javicone/LoRaLAN_TFG/TFG_JavierConejero_Latex/portada/portadaCUMDatos.tex

\pagestyle{empty}

\begin{center}
	\newcommand{\HRule}{\rule{\linewidth}{0.7mm}}
	\begin{minipage}{0.48\textwidth} 
		\begin{flushleft}
			\\[2.5cm]
		\end{flushleft}
	\end{minipage}
	\begin{minipage}{0.48\textwidth} 
		\begin{flushright}
			\\[2.5cm]
		\end{flushright}
	\end{minipage}	
	
	\vspace*{2cm}
	\textsc{\large Universidad de Extremadura}\\[0.5cm]
	\textsc{\large Centro Universitario de Mérida}\\[1.3cm]
	\textsc{\LARGE Grado en Ingeniería Telemática en Telecomunicación}\\[1.3cm]
	\textsc{\huge Trabajo Fin de Grado}\\[2cm]
	%{ \large Diseño de metaheurísticas especializadas para la optimización de cadenas de servicios en redes 5G}\\
	\textsc{\LARGE Diseño e implementación de un protocolo de red de área local sobre tecnología LoRa para redes privadas orientadas a IoT}\\[2.5 cm]
\end{center}

\begin{flushleft}
	\begin{tabular}{ll}
		% Nombre del alumno.
		\large{\textbf{Autor:}}
		\large{Javier Conejero Rodríguez} \\
		\large{\textbf{Fdo:}} & \\
		\\
		\\
		\\
		% Nombre del director/tutor del proyecto.
		\large{\textbf{Tutor:}}
        \large{Pedro José Pardo Fernández} \\
        \large{\textbf{  Fdo:}}\\
        \\
        \\
        \\
        \large{\textbf{Tutor:}}
        \large{Francisco Díaz Barrancas} \\
        \large{\textbf{  Fdo:}}\\
	\end{tabular}
\end{flushleft}
