javicone/LoRaLAN_TFG/TFG_JavierConejero_Latex/principal.tex

\documentclass[a4paper,12pt,openright,twoside]{book}  

%Paquetes
\usepackage[utf8]{inputenc}
\usepackage[spanish]{babel}
\usepackage{graphicx} 
\usepackage{array}
\usepackage{wrapfig}   
\usepackage[scriptsize]{caption} 
\usepackage{amsmath} 
\usepackage{amsthm}  
\usepackage{float}   
\usepackage{lastpage}
\usepackage{pdfpages}
\usepackage{url}
% Package rotating -> Para poder girar las tablas y dibujarlas a lo largo
% del folio en vez de a lo ancho.
\usepackage{rotating}
% Packages multicol y multirow, para manejar tablas de filas y columnas múltiples.
\usepackage{multicol}
\usepackage{multirow}
\usepackage{colortbl}
%Para codigo maquina
\usepackage{listings}
%Para hypervínculos en el indice
\usepackage[hidelinks]{hyperref}
\usepackage{pdfpages}
\usepackage{lscape}
\usepackage{eurosym}
\usepackage{listings}
\usepackage{xcolor}

\usepackage{tabularx}
\usepackage{booktabs}
\usepackage{longtable}

\usepackage{array}

\lstdefinestyle{sharpc}{language=[Sharp]C}

\usepackage{appendix}

\usepackage{epstopdf} 
\usepackage{subcaption}
%Renombramientos

\usepackage{enumitem}
\usepackage{tikz}
\newcommand*\circled[1]{\tikz[baseline=(c.base)]{
    \node[shape=circle,fill=black,text=white,inner sep=1.2pt,
          font=\footnotesize\bfseries] (c) {#1};}}

\renewcommand{\contentsname}{Índice de contenido}
\renewcommand{\chaptername}{Capítulo}            
\renewcommand{\bibname}{References} 
\renewcommand{\listfigurename}{Índice de figuras}
\renewcommand{\listtablename}{Índice de tablas}
\renewcommand{\figurename}{Figura}
\renewcommand{\tablename}{Tabla}
\addto\captionsspanish{\renewcommand{\appendixname}{Anexo}}
%\renewcommand{\appendixname}{Anexo}
\renewcommand{\appendixtocname}{Anexos}
\renewcommand{\appendixpagename}{Anexos}
\renewcommand{\lstlistingname}{Listado}

\newcolumntype{C}[1]{>{\centering\arraybackslash}m{#1}}

\providecommand{\keywords}[1]{\textbf{\textit{Keywords---}} #1}

%\setcounter{secnumdepth}{4}
%\setcounter{tocdepth}{4}

%Configuración páginas
\include{config/paginas}

\begin{document}

\include{portada/portadaCUM}
\cleardoublepage
\include{portada/portadaCUMDatos}
\cleardoublepage

\pagestyle{plain}
\pagenumbering{Roman} % para comenzar la numeración de paginas en números romanos

\include{paginasiniciales/agradecimientos}
\cleardoublepage

\include{paginasiniciales/resumen}
\cleardoublepage

\include{paginasiniciales/abstract}
\cleardoublepage

\pagestyle{plain}
\tableofcontents

\addcontentsline{toc}{chapter}{Índice de figuras}
\listoffigures

\cleardoublepage
%\addcontentsline{toc}{chapter}{Índice de tablas}
%\listoftables
%\cleardoublepage

%\pagestyle{fancy} 
\pagenumbering{arabic}

% CAPÍTULOS -----------------------------------
\include{capitulos/capitulo1}
\include{capitulos/capitulo2}
\include{capitulos/capitulo3}
\include{capitulos/capitulo4}
\include{capitulos/capitulo5}
\include{capitulos/capitulo6}
\include{capitulos/capitulo7}
\include{capitulos/capitulo8}
% etc...

%----------------------------------------------------
% INCLUIMOS LOS ANEXOS (SI ES NECESARIO)
\appendix
\clearpage
\addappheadtotoc
\appendixpage
\include{anexos/an1}
\include{anexos/an2}
\include{anexos/an3}
\include{anexos/an4}

\addcontentsline{toc}{chapter}{Bibliografía}
%\nocite{*}	% Se usa para indicar en la bibliografía las referencias no citadas.
\pagestyle{plain}
\bibliography{bibliografia/referencias}{}
\bibliographystyle{ieeetr}
%\bibliographystyle{plain}
\end{document}
