javicone/LoRaLAN_TFG/TFG_JavierConejero_Latex/paginasiniciales/ack.tex

\chapter*{Agradecimientos} 
\addcontentsline{toc}{chapter}{Agradecimientos} % si queremos que aparezcan en el índice
  Si tienes algo que agradecer
