javicone/LoRaLAN_TFG/TFG_JavierConejero_Latex/paginasiniciales/agradecimientos.tex

\chapter*{Agradecimientos}

¡Al fin cierro mi etapa como estudiante universitario!

Quería agredecer a mi tutor, Pedro, todo el apoyo brindado durante la realización de este trabajo. Sin su ambición este proyecto no habría sido posible y, de primeras, jamás me hubiera lanzado a trabajar a tan bajo nivel diseñando un protocolo dede cero.

Este trabajo ha supuesto un reto para mi, no por la complejidad del contenido en sí mismo, sino por la dificultad que conlleva trabajar con materias tan diferenciadas. 

Gracias también a ti, Sofía. Desde que estás en mi vida solo me han pasado cosas buenas y las que no han sido buenas, han sido menos malas. Eres capaz de sacar lo mejor de mí y eso no tiene precio. Siempre estaré ahí, para apoyarte y ayudarte, al igual que tú haces conmigo.
