javicone/LoRaLAN_TFG/TFG_JavierConejero_Latex/imagenes/IMG_20261105_010422259.jpg

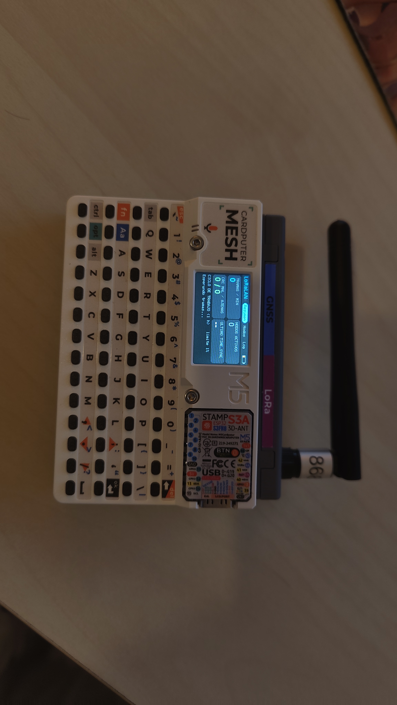
TFG_JavierConejero_Latex/imagenes/IMG_20261105_010422259.jpg
