javicone/LoRaLAN_TFG/TFG_JavierConejero_Latex/imagenes/IMG_20261105_010449758.jpg

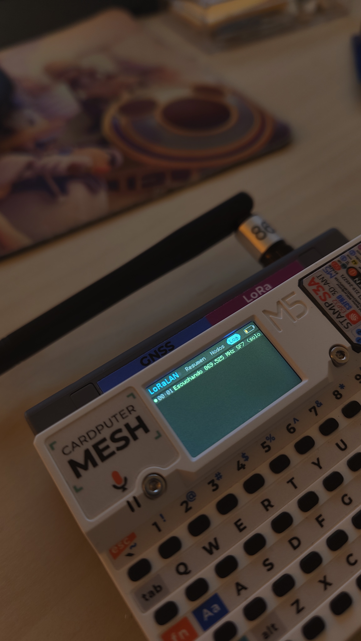
TFG_JavierConejero_Latex/imagenes/IMG_20261105_010449758.jpg
