javicone/LoRaLAN_TFG/TFG_JavierConejero_Latex/imagenes/lorawan.webp

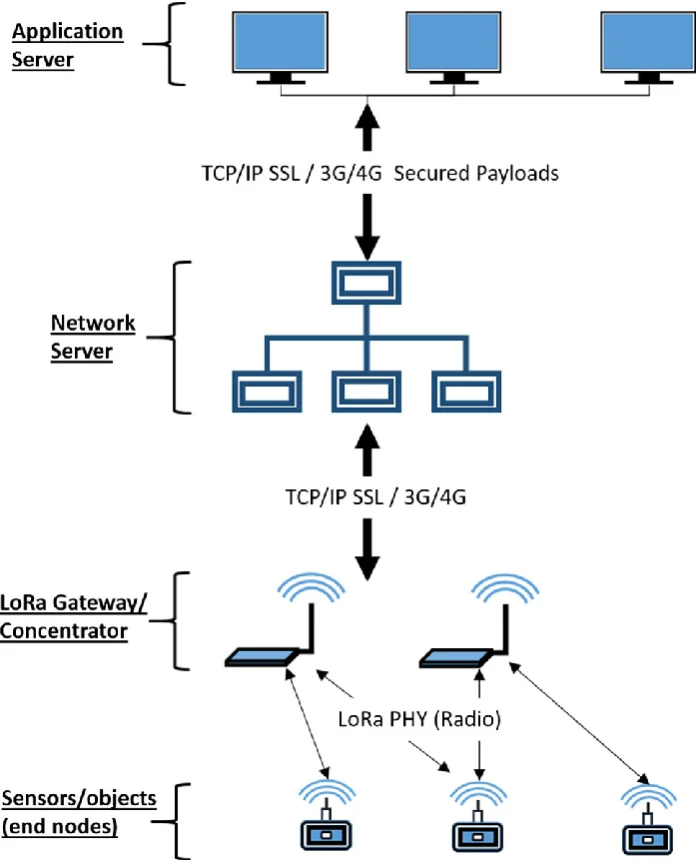
TFG_JavierConejero_Latex/imagenes/lorawan.webp
