javicone/LoRaLAN_TFG/TFG_JavierConejero_Latex/imagenes/TRAMA LORALAN.png

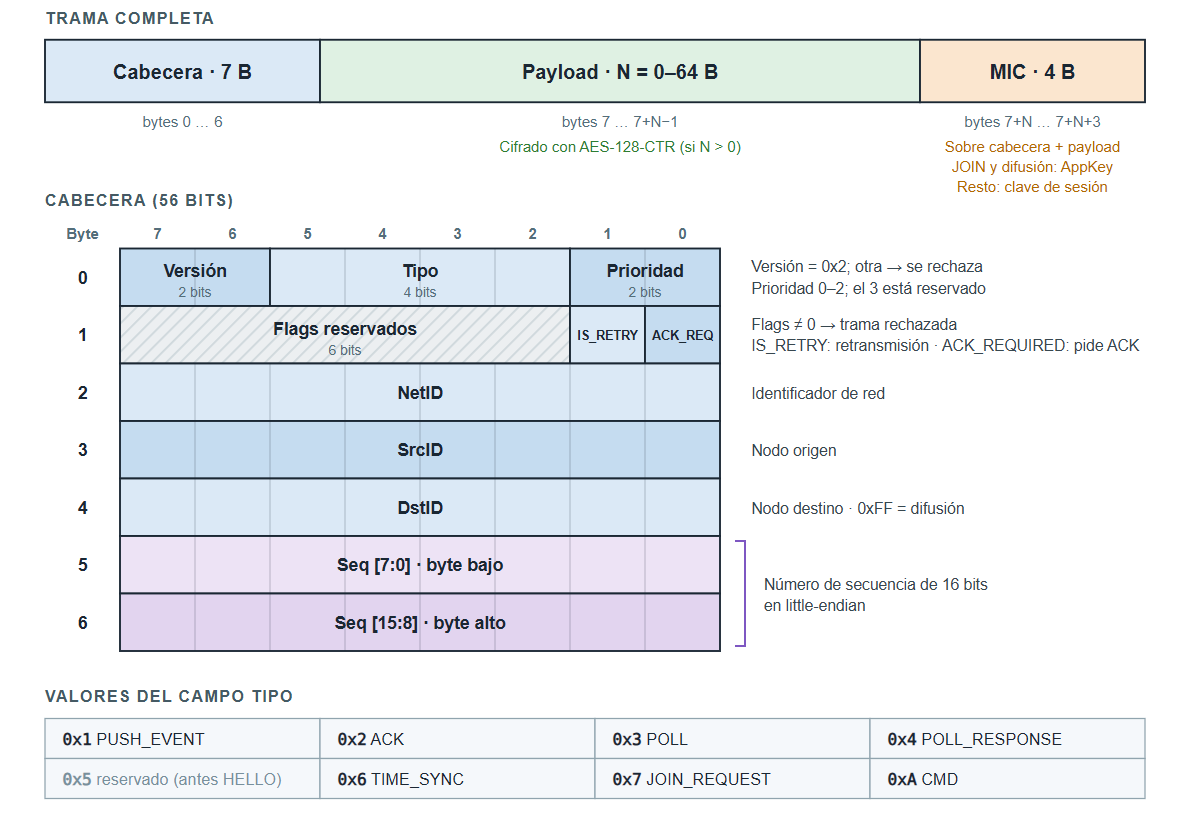
TFG_JavierConejero_Latex/imagenes/TRAMA LORALAN.png
