javicone/LoRaLAN_TFG/LORALAN_LIB/sim_LoRaLAN/results/casos.csv

id | familia | titulo | fecha_esperado | precondiciones | estimulo | requisito | propiedad | veredicto | conocido | observado | semilla
D1 | ACK | La aplicacion responde rapido | 2026-11-01 | Gateway con ACK diferido | Respuesta a los 100 ms | PRO-3 | El codigo llega al nodo dentro del ACK, sin retransmisiones | Superada |  |  | 42
D2 | ACK | La aplicacion responde tarde | 2026-11-01 | Gateway con ACK diferido | Respuesta a los 2000 ms | PRO-3 | El nodo repite durante la espera, pero la aplicacion no recibe duplicado | Superada |  |  | 42
D2 | ACK | La aplicacion responde tarde | 2026-11-01 | Gateway con ACK diferido | Respuesta a los 2000 ms | PRO-3 | La respuesta llega al nodo | Superada |  |  | 42
D3 | ACK | ACK con la respuesta perdido | 2026-11-01 | Gateway con ACK diferido | Se descarta el 1.er ACK de bajada | PRO-3 | La retransmision recibe la misma respuesta guardada, sin duplicado | Superada |  |  | 42
D4 | ACK | La aplicacion nunca responde | 2026-11-01 | Gateway con ACK diferido | Sin ackPush | PRO-3 | Agotados los intentos, el nodo recibe delivered=false | Superada |  |  | 42
D6 | ACK | POLL durante la espera | 2026-11-01 | Gateway con ACK diferido | La aplicacion responde mientras el nodo contesta a un POLL | PRO-3 | El ACK no se pierde por la respuesta al POLL | Fallida |  | ACK destruidos: observado 1, esperado 0 | emisiones del evento: observado 2, esperado 1 | 42
C1 | CMD | Orden con canal limpio | 2026-11-01 | Un nodo asociado | Ninguno | PRO-4 | Se descifra y se ejecuta una vez, y se confirma | Superada |  |  | 42
C1 | CMD | Orden con canal limpio | 2026-11-01 | Un nodo asociado | Ninguno | PRO-8 | Los bytes en el aire no contienen el texto claro | Superada |  |  | 42
C2 | CMD | Orden perdida | 2026-11-01 | Un nodo asociado | Se descarta el 1.er CMD | PRO-5 | El gateway reintenta y la orden se ejecuta una vez | Superada |  |  | 42
C2 | CMD | Orden perdida | 2026-11-01 | Un nodo asociado | Se descarta el 1.er CMD | PRO-5 | Aunque llegue un POLL antes del reintento, la orden se ejecuta una vez | Superada |  |  | 42
C3 | CMD | ACK del nodo perdido | 2026-11-01 | Un nodo asociado | Se descarta el 1.er ACK de subida | PRO-5 | El gateway retransmite la orden una vez | Superada |  |  | 42
C3 | CMD | ACK del nodo perdido | 2026-11-01 | Un nodo asociado | Se descarta el 1.er ACK de subida | PRO-4 | El nodo ejecuta la orden como mucho una vez | Superada |  |  | 42
C4 | CMD | Orden a un nodo no asociado | 2026-11-01 | Un nodo sin asociar | sendCommand | PRO-4 | sendCommand devuelve false y no emite nada | Superada |  |  | 42
C5 | CMD | Orden con otra en espera | 2026-11-01 | Orden A sin confirmar | Orden B | PRO-4 | La segunda se rechaza y la aplicacion puede reintentar al terminar la primera | Superada |  |  | 42
C7 | CMD | Repeticion de una orden capturada | 2026-11-01 | Orden ya ejecutada; atacante con la trama | Reinyeccion | PRO-8 | La repeticion se rechaza: la orden no se ejecuta otra vez | Superada |  |  | 42
C7 | CMD | Repeticion de una orden capturada | 2026-11-01 | Orden ya ejecutada; atacante con la trama | Reinyeccion | PRO-8 | Tambien se rechaza la repeticion de una orden que no es la ultima | Superada |  |  | 42
C7 | CMD | Repeticion de una orden capturada | 2026-11-01 | Orden ya ejecutada; atacante con la trama | Reinyeccion | PRO-8 | Una orden nueva se ejecuta tras mas de media escala del contador sin ordenes | Superada |  |  | 42
F1 | FORMATO | Ida y vuelta de cada tipo de trama | 2026-11-01 | Ninguna | Construir y volver a leer | PRO-8 | Cada campo leido coincide con el construido y el MIC se verifica | Superada |  |  | 42
F2 | FORMATO | Limites de longitud de trama | 2026-11-01 | Ninguna | Longitudes 10, 11, 75 y 76 B | RNF-3 | Solo se aceptan tramas de 11 a 75 bytes | Superada |  |  | 42
F3 | FORMATO | Secuencia de 16 bits y vuelta en 0xFFFF | 2026-11-01 | Ninguna | Avanzar de 0xFFFE a 0x0000 | PRO-8 | El campo conserva los 16 bits | Superada |  |  | 42
F3 | FORMATO | Secuencia de 16 bits y vuelta en 0xFFFF | 2026-11-01 | Ninguna | Avanzar de 0xFFFE a 0x0000 | PRO-8 | La deteccion de repeticiones sigue funcionando al dar la vuelta | Superada |  |  | 42
F3 | FORMATO | Secuencia de 16 bits y vuelta en 0xFFFF | 2026-11-01 | Ninguna | Avanzar de 0xFFFE a 0x0000 | PRO-8 | Una secuencia anterior no vista se acepta una sola vez; una muy antigua, ninguna | Superada |  |  | 42
F3 | FORMATO | Secuencia de 16 bits y vuelta en 0xFFFF | 2026-11-01 | Ninguna | Avanzar de 0xFFFE a 0x0000 | PRO-8 | Un salto hacia delante de hasta media escala se acepta | Superada |  |  | 42
F4 | FORMATO | MIC sensible a cada byte | 2026-11-01 | Trama de 8 B de carga sellada | Alterar cada byte | PRO-8 | La trama intacta se verifica | Superada |  |  | 42
F4 | FORMATO | MIC sensible a cada byte | 2026-11-01 | Trama de 8 B de carga sellada | Alterar cada byte | PRO-8 | Alterar cualquier byte invalida el MIC | Superada |  |  | 42
F4 | FORMATO | MIC sensible a cada byte | 2026-11-01 | Trama de 8 B de carga sellada | Alterar cada byte | PRO-8 | Otra clave invalida el MIC | Superada |  |  | 42
F5 | FORMATO | Campos de cabecera invalidos | 2026-11-01 | Trama valida | Version, tipo, prioridad o indicadores invalidos | PRO-8 | La trama de control se acepta | Superada |  |  | 42
F5 | FORMATO | Campos de cabecera invalidos | 2026-11-01 | Trama valida | Version, tipo, prioridad o indicadores invalidos | PRO-8 | Lectura: cada campo invalido se rechaza | Superada |  |  | 42
F5 | FORMATO | Campos de cabecera invalidos | 2026-11-01 | Trama valida | Version, tipo, prioridad o indicadores invalidos | PRO-8 | Construccion: no se fabrica una trama invalida | Superada |  |  | 42
F6 | FORMATO | Carga de 0, 1, 64 y 65 B | 2026-11-01 | Ninguna | Construir con esas cargas | RNF-3 | Se acepta hasta 64 bytes de carga, con su longitud total correcta | Superada |  |  | 42
F6 | FORMATO | Carga de 0, 1, 64 y 65 B | 2026-11-01 | Ninguna | Construir con esas cargas | RNF-3 | Se rechaza una carga de 65 bytes | Superada |  |  | 42
J1 | JOIN | Asociacion con canal limpio | 2026-11-01 | Gateway y un nodo recien arrancados, canal limpio | Ninguno | PRO-6 | El nodo queda asociado tras un unico intercambio JOIN_REQUEST y JOIN_ACCEPT | Superada |  |  | 42
J1 | JOIN | Asociacion con canal limpio | 2026-11-01 | Gateway y un nodo recien arrancados, canal limpio | Ninguno | PRO-6 | La aplicacion de cada extremo recibe un unico aviso de la asociacion | Superada |  |  | 42
J10 | JOIN | Direccion ocupada o sin preferencia | 2026-11-01 | Un nodo pide 0x20, otro pide la misma y otro no pide ninguna | Ninguno | PRO-6 | El primero conserva la pedida y los otros reciben una libre del rango dinamico | Superada |  |  | 42
J10 | JOIN | Direccion ocupada o sin preferencia | 2026-11-01 | Un nodo pide 0x20, otro pide la misma y otro no pide ninguna | Ninguno | PRO-6 | El nodo que cambio de direccion funciona con la asignada | Superada |  |  | 42
J12 | JOIN | Repeticion del ultimo JOIN | 2026-11-01 | Nodo asociado; atacante con su JOIN_REQUEST | Reinyeccion | PRO-8 | La repeticion se rechaza | Superada |  |  | 42
J12 | JOIN | Repeticion del ultimo JOIN | 2026-11-01 | Nodo asociado; atacante con su JOIN_REQUEST | Reinyeccion | PRO-8 | La sesion sigue intacta | Superada |  |  | 42
J13 | JOIN | Repeticion de un JOIN antiguo | 2026-11-01 | Nodo reasociado; atacante con el JOIN_REQUEST de la sesion anterior | Reinyeccion | PRO-8 | La repeticion se rechaza | Fallida | J13: el gateway solo recuerda el ultimo DevNonce | JOIN_ACCEPT emitidos: observado 1, esperado 0 | avisos de asociacion: observado 1, esperado 0 | 42
J13 | JOIN | Repeticion de un JOIN antiguo | 2026-11-01 | Nodo reasociado; atacante con el JOIN_REQUEST de la sesion anterior | Reinyeccion | PRO-8 | La sesion sigue intacta | Fallida | J13: el gateway solo recuerda el ultimo DevNonce | un evento llega | 42
J15 | JOIN | Envios antes de asociarse | 2026-11-01 | Nodo sin asociar | Encolar evento y carga | PRO-6 | Sin asociacion no se acepta ningun envio | Superada |  |  | 42
J2 | JOIN | JOIN_REQUEST perdido | 2026-11-01 | Nodo recien arrancado | Se descarta el 1.er JOIN_REQUEST | PRO-6 | Repite el JOIN_REQUEST pasado joinRetryMs y queda asociado | Superada |  |  | 42
J2 | JOIN | JOIN_REQUEST perdido | 2026-11-01 | Nodo recien arrancado | Se descarta el 1.er JOIN_REQUEST | PRO-6 | El reintento lleva un DevNonce nuevo | Superada |  |  | 42
J3 | JOIN | JOIN_ACCEPT perdido | 2026-11-01 | Nodo recien arrancado | Se descarta el 1.er JOIN_ACCEPT | PRO-6 | El nodo repite y el gateway reutiliza la entrada y la direccion | Superada |  |  | 42
J3 | JOIN | JOIN_ACCEPT perdido | 2026-11-01 | Nodo recien arrancado | Se descarta el 1.er JOIN_ACCEPT | PRO-6 | Ambos extremos acaban con la misma clave de sesion | Superada |  |  | 42
J4 | JOIN | Canal ocupado al asociarse | 2026-11-01 | Emisor ajeno de 1500 ms desde el arranque | Canal ocupado | PRO-3 | No transmite con el canal ocupado | Superada |  |  | 42
J4 | JOIN | Canal ocupado al asociarse | 2026-11-01 | Emisor ajeno de 1500 ms desde el arranque | Canal ocupado | PRO-3 | Reintenta despues y queda asociado | Superada |  |  | 42
J5 | JOIN | Varios nodos se asocian a la vez | 2026-11-01 | Cuatro nodos con el mismo joinRetryMs | Arranque simultaneo | PRO-1 | Con escucha ideal, todos quedan asociados con su direccion | Superada |  |  | 42
J5 | JOIN | Varios nodos se asocian a la vez | 2026-11-01 | Cuatro nodos con el mismo joinRetryMs | Arranque simultaneo | PRO-1 | Con ventana ciega de 2 ms, todos quedan asociados con su direccion | Superada |  |  | 42
J6 | JOIN | Nodo reiniciado con sesion viva | 2026-11-01 | Nodo asociado que ya emitio 3 eventos | Reinicio del nodo | PRO-6 | El nodo reiniciado establece una sesion nueva | Superada |  |  | 42
J6 | JOIN | Nodo reiniciado con sesion viva | 2026-11-01 | Nodo asociado que ya emitio 3 eventos | Reinicio del nodo | PRO-6 | La secuencia se reinicia: un evento con numero bajo se acepta | Superada |  |  | 42
J7 | JOIN | Clave maestra incorrecta | 2026-11-01 | Nodo con otra APPKEY | Ninguno | PRO-6 | El nodo nunca queda asociado | Superada |  |  | 42
J7 | JOIN | Clave maestra incorrecta | 2026-11-01 | Nodo con otra APPKEY | Ninguno | PRO-6 | El gateway no guarda ningun estado | Superada |  |  | 42
J8 | JOIN | Otro identificador de red | 2026-11-01 | Nodo con otro netId | Ninguno | PRO-6 | El gateway ignora las tramas de otra red | Superada |  |  | 42
J9 | JOIN | Tabla llena | 2026-11-01 | 33 nodos para 32 entradas | Ninguno | RNF-3 | Solo se admiten 32 nodos y el 33.o se rechaza | Superada |  |  | 42
J9 | JOIN | Tabla llena | 2026-11-01 | 33 nodos para 32 entradas | Ninguno | RNF-3 | Los nodos admitidos no se ven afectados | Superada |  |  | 42
L1 | LEAVE | Baja con canal limpio | 2026-11-01 | Un nodo asociado | Ninguno | PRO-6 | El gateway confirma la baja una vez y avisa a su aplicacion una vez | Superada |  |  | 42
L1 | LEAVE | Baja con canal limpio | 2026-11-01 | Un nodo asociado | Ninguno | PRO-6 | Ambos extremos terminan la sesion | Superada |  |  | 42
L1 | LEAVE | Baja con canal limpio | 2026-11-01 | Un nodo asociado | Ninguno | PRO-6 | El nodo no se reasocia solo | Superada |  |  | 42
L10 | LEAVE | Repeticion de un LEAVE | 2026-11-01 | Nodo reasociado; atacante con el LEAVE de la sesion anterior | Reinyeccion | PRO-8 | La repeticion se rechaza y el nodo sigue asociado | Superada |  |  | 42
L2 | LEAVE | ACK de la baja perdido | 2026-11-01 | Un nodo asociado | Se descarta el 1.er ACK de bajada | PRO-6 | El nodo retransmite el LEAVE | Superada |  |  | 42
L2 | LEAVE | ACK de la baja perdido | 2026-11-01 | Un nodo asociado | Se descarta el 1.er ACK de bajada | PRO-6 | El gateway avisa una sola vez y el nodo acaba de baja | Superada |  |  | 42
L3 | LEAVE | LEAVE perdido siempre | 2026-11-01 | Un nodo asociado con sondeo cada 1 s | Se descartan todos los LEAVE | PRO-6 | Baja local al agotar los intentos | Superada |  |  | 42
L3 | LEAVE | LEAVE perdido siempre | 2026-11-01 | Un nodo asociado con sondeo cada 1 s | Se descartan todos los LEAVE | PRO-6 | El gateway acaba viendolo inactivo | Superada |  |  | 42
L4 | LEAVE | Baja mientras espera otro ACK | 2026-11-01 | Evento enviado sin ACK aun | leave() durante la espera | PRO-6 | leave() devuelve false y el nodo sigue asociado | Fallida |  | el nodo sigue asociado | 42
L5 | LEAVE | Baja con un evento en cola | 2026-11-01 | Evento encolado que aun no ha salido | leave() inmediato | PRO-5 | La baja se completa | Superada |  |  | 42
L5 | LEAVE | Baja con un evento en cola | 2026-11-01 | Evento encolado que aun no ha salido | leave() inmediato | PRO-5 | El evento se descarta avisando a la aplicacion | Fallida |  | avisos de no entregado: observado 0, esperado 1 | 42
L6 | LEAVE | POLL o CMD durante la baja | 2026-11-01 | Baja en curso; el gateway no recibe el LEAVE | POLL y CMD | PRO-6 | No responde al POLL | Superada |  |  | 42
L6 | LEAVE | POLL o CMD durante la baja | 2026-11-01 | Baja en curso; el gateway no recibe el LEAVE | POLL y CMD | PRO-6 | No ejecuta la orden ni la confirma | Superada |  |  | 42
L7 | LEAVE | Reasociacion tras la baja | 2026-11-01 | Nodo de baja | requestJoin() | PRO-6 | Sesion nueva con la misma direccion | Superada |  |  | 42
L9 | LEAVE | Baja de un nodo entre varios | 2026-11-01 | Tres nodos con sondeo cada 1 s | Baja del nodo central | PRO-6 | El sondeo salta la entrada del nodo de baja | Superada |  |  | 42
L9 | LEAVE | Baja de un nodo entre varios | 2026-11-01 | Tres nodos con sondeo cada 1 s | Baja del nodo central | PRO-6 | Los demas nodos reparten los turnos y siguen asociados | Superada |  |  | 42
P1 | POLL | POLL sin datos | 2026-11-01 | Un nodo asociado sin nada que enviar | POLL | PRO-2 | Respuesta vacia, una vez y sin ACK | Superada |  |  | 42
P10 | POLL | Reparto con varios nodos | 2026-11-01 | Cuatro nodos con sondeo cada 1 s | Ninguno | PRO-1 | Round-robin justo: el turno de cada nodo llega cada N intervalos | Superada |  |  | 42
P10 | POLL | Reparto con varios nodos | 2026-11-01 | Cuatro nodos con sondeo cada 1 s | Ninguno | PRO-1 | Con 3 nodos, el reparto sigue siendo justo tras mas de 256 sondeos | Superada |  |  | 42
P11 | POLL | Nodo que deja de contestar y vuelve | 2026-11-01 | Un nodo con sondeo cada 1 s | Enlace de subida cortado 8 s | PRO-2 | El gateway lo declara inactivo una vez y sigue sondeandolo | Superada |  |  | 42
P11 | POLL | Nodo que deja de contestar y vuelve | 2026-11-01 | Un nodo con sondeo cada 1 s | Enlace de subida cortado 8 s | PRO-2 | Al volver a contestar se reactiva, sin nuevos avisos | Superada |  |  | 42
P14 | POLL | POLL mientras el nodo espera un ACK | 2026-11-01 | Evento con el 1.er ACK perdido | POLL justo antes del reintento | PRO-5 | La respuesta al POLL no impide recibir el ACK esperado | Superada |  |  | 42
P2 | POLL | Respuesta bajo demanda | 2026-11-01 | Nodo con onPollRequest | POLL | PRO-2 | Una emision con los datos, sin ACK | Superada |  |  | 42
P3 | POLL | Carga con ACK | 2026-11-01 | Carga encolada con ACK | POLL | PRO-2 | Se entrega, se confirma y se borra del nodo | Superada |  |  | 42
P4 | POLL | Carga con ACK perdido | 2026-11-01 | Carga encolada con ACK | Se descartan los 3 primeros ACK | PRO-5 | Sin ACK, la carga se conserva y los reintentos no se entregan dos veces | Superada |  |  | 42
P4 | POLL | Carga con ACK perdido | 2026-11-01 | Carga encolada con ACK | Se descartan los 3 primeros ACK | PRO-5 | Se repite en el siguiente sondeo y entonces se borra | Superada |  |  | 42
P5 | POLL | Carga sin ACK | 2026-11-01 | Carga encolada sin ACK | POLL | PRO-2 | Una emision y se borra | Superada |  |  | 42
P6 | POLL | Carga sobre carga pendiente | 2026-11-01 | Carga A pendiente | Encolar carga B | PRO-5 | queuePollPayload devuelve false y no sobrescribe | Fallida |  | la segunda carga debe rechazarse | llega la primera carga: observado 0, esperado 1 | 42
P7 | POLL | POLL dirigido a otro nodo | 2026-11-01 | Dos nodos asociados | POLL al nodo 1 | PRO-2 | Solo responde el destinatario | Superada |  |  | 42
P8 | POLL | POLL perdido | 2026-11-01 | Un nodo con sondeo cada 1 s | Se descarta el 1.er POLL | PRO-2 | Llega el siguiente turno y un solo POLL perdido no lo marca inactivo | Superada |  |  | 42
P9 | POLL | POLL_RESPONSE perdida | 2026-11-01 | Un nodo con carga | Se descarta la 1.a respuesta | PRO-5 | Sin ACK, el dato se pierde | Superada |  |  | 42
P9 | POLL | POLL_RESPONSE perdida | 2026-11-01 | Un nodo con carga | Se descarta la 1.a respuesta | PRO-5 | Con ACK, se repite y llega una vez | Superada |  |  | 42
U1 | PUSH | Evento en reposo con el canal libre | 2026-11-01 | Un nodo asociado, canal limpio, sin sondeo | Ninguno | PRO-3 | Comprueba el canal una vez y emite el evento sin esperar turno | Superada |  |  | 42
U1 | PUSH | Evento en reposo con el canal libre | 2026-11-01 | Un nodo asociado, canal limpio, sin sondeo | Ninguno | RNF-1 | El evento llega a la aplicacion del gateway en un tiempo en el aire | Superada |  |  | 42
U1 | PUSH | Evento en reposo con el canal libre | 2026-11-01 | Un nodo asociado, canal limpio, sin sondeo | Ninguno | PRO-3 | El gateway confirma una vez y la aplicacion del nodo conoce el desenlace | Superada |  |  | 42
U10 | PUSH | Dos eventos seguidos | 2026-11-01 | Un nodo asociado | Dos queuePushEvent seguidos | PRO-3 | El segundo se rechaza mientras el primero no haya salido | Superada |  |  | 42
U11 | PUSH | Evento mientras otro espera ACK | 2026-11-01 | Evento A con el 1.er ACK perdido | Evento B durante la espera | PRO-3 | El segundo espera a que termine el primero y despues sale | Superada |  |  | 42
U11 | PUSH | Evento mientras otro espera ACK | 2026-11-01 | Evento A con el 1.er ACK perdido | Evento B durante la espera | PRO-3 | Los dos se entregan y se confirman | Superada |  |  | 42
U12 | PUSH | Evento justo cuando empieza un POLL | 2026-11-01 | Un nodo asociado | POLL 1 ms despues del evento | PRO-3 | Colisionan una vez, se reintenta y se entrega una vez | Superada |  |  | 42
U13 | PUSH | Evento mientras se responde a un POLL | 2026-11-01 | Respuesta al POLL en el aire | Evento durante la respuesta | PRO-3 | El propio nodo espera a terminar la respuesta, sin colision | Superada |  |  | 42
U13 | PUSH | Evento mientras se responde a un POLL | 2026-11-01 | Respuesta al POLL en el aire | Evento durante la respuesta | PRO-3 | Otro nodo detecta la respuesta y espera, sin colision | Superada |  |  | 42
U14 | PUSH | Evento con una carga con ACK en curso | 2026-11-01 | Respuesta con ACK, con el 1.er ACK perdido | Evento durante la espera | PRO-3 | El evento espera a que termine el envio fiable en curso | Superada |  |  | 42
U14 | PUSH | Evento con una carga con ACK en curso | 2026-11-01 | Respuesta con ACK, con el 1.er ACK perdido | Evento durante la espera | PRO-3 | Ambos se entregan | Superada |  |  | 42
U15 | PUSH | Reintento con el canal ocupado | 2026-11-01 | Evento con el 1.er ACK perdido | Emisor ajeno durante el instante del reintento | PRO-3 | El reintento escucha antes de transmitir | Fallida |  | debe detectar el canal ocupado | 42
U16 | PUSH | Varios nodos colisionan | 2026-11-01 | Cuatro nodos asociados y ventana ciega de 2 ms | Eventos en el mismo instante | PRO-3 | Dejan de coincidir y todos entregan | Fallida |  | entregas: observado 2, esperado 4 | confirmados: observado 2, esperado 4 | 42
U17 | PUSH | Reinicio del gateway con un evento en curso | 2026-11-01 | Nodo con deteccion de silencio de 10 s | Reinicio del gateway con el evento en el aire | PRO-5 | El evento se da por no entregado y la aplicacion lo sabe | Superada |  |  | 42
U17 | PUSH | Reinicio del gateway con un evento en curso | 2026-11-01 | Nodo con deteccion de silencio de 10 s | Reinicio del gateway con el evento en el aire | PRO-9 | El nodo se reasocia por silencio y el enlace vuelve a funcionar | Superada |  |  | 42
U19 | PUSH | Evento de 0, 1, 64 y 65 B | 2026-11-01 | Un nodo asociado | Encolar esas cargas | RNF-3 | Se acepta y se entrega hasta 64 bytes | Superada |  |  | 42
U19 | PUSH | Evento de 0, 1, 64 y 65 B | 2026-11-01 | Un nodo asociado | Encolar esas cargas | RNF-3 | Se rechazan 65 bytes | Superada |  |  | 42
U2 | PUSH | Evento sin ACK | 2026-11-01 | Un nodo asociado | Evento sin confirmacion | PRO-3 | Una emision, una entrega y sin ACK | Superada |  |  | 42
U20 | PUSH | Tras 63 y 64 perdidas seguidas | 2026-11-01 | Un nodo asociado | Subida cortada durante N eventos | PRO-5 | Tras 63 perdidas recupera la comunicacion | Superada |  |  | 42
U20 | PUSH | Tras 63 y 64 perdidas seguidas | 2026-11-01 | Un nodo asociado | Subida cortada durante N eventos | PRO-5 | Tras 64 perdidas recupera la comunicacion | Superada |  |  | 42
U22 | PUSH | Evento perdido y POLL antes del reintento | 2026-11-01 | Un nodo asociado | Se descarta el 1.er PUSH_EVENT y llega un POLL antes del reintento | PRO-5 | Si el nodo recibe la confirmacion, la aplicacion del gateway recibio el evento | Superada |  |  | 42
U3 | PUSH | Canal ocupado | 2026-11-01 | Emisor ajeno de 500 ms | Evento con el canal ocupado | PRO-3 | Aplaza con espera creciente | Superada |  |  | 42
U3 | PUSH | Canal ocupado | 2026-11-01 | Emisor ajeno de 500 ms | Evento con el canal ocupado | PRO-3 | Transmite cuando se libera, sin solape, y se entrega | Superada |  |  | 42
U4 | PUSH | Canal ocupado de forma permanente | 2026-11-01 | Emisor ajeno de 120 s | Evento con el canal ocupado | PRO-5 | Limite de intentos de escucha y aviso a la aplicacion | Superada |  |  | 42
U4 | PUSH | Canal ocupado de forma permanente | 2026-11-01 | Emisor ajeno de 120 s | Evento con el canal ocupado | PRO-5 | Tras desistir, un evento nuevo sale con el canal libre | Superada |  |  | 42
U4 | PUSH | Canal ocupado de forma permanente | 2026-11-01 | Emisor ajeno de 120 s | Evento con el canal ocupado | PRO-5 | Con rescate, el evento abandonado se entrega por la via del sondeo | Superada |  |  | 42
U5 | PUSH | Primera emision perdida | 2026-11-01 | Un nodo asociado | Se descarta el 1.er PUSH_EVENT | PRO-5 | Un reintento y una sola entrega | Superada |  |  | 42
U6 | PUSH | Evento con el primer ACK perdido | 2026-11-01 | Un nodo asociado, canal limpio, sin sondeo | Se descarta el 1.er ACK de bajada | PRO-5 | Sin confirmacion, el nodo retransmite el evento una vez | Superada |  |  | 42
U6 | PUSH | Evento con el primer ACK perdido | 2026-11-01 | Un nodo asociado, canal limpio, sin sondeo | Se descarta el 1.er ACK de bajada | PRO-5 | La aplicacion del gateway recibe el evento una sola vez | Superada |  |  | 42
U6 | PUSH | Evento con el primer ACK perdido | 2026-11-01 | Un nodo asociado, canal limpio, sin sondeo | Se descarta el 1.er ACK de bajada | PRO-5 | El gateway reconfirma y el nodo da el evento por entregado | Superada |  |  | 42
U7 | PUSH | Todo perdido, sin rescate | 2026-11-01 | Un nodo asociado | Se descartan todos los PUSH_EVENT | PRO-5 | Un numero acotado de emisiones y aviso de no entregado | Superada |  |  | 42
U8 | PUSH | Todo perdido, con rescate | 2026-11-01 | Evento con rescate | Se descartan todos los PUSH_EVENT | PRO-5 | Agotados los intentos, la aplicacion lo sabe y el evento queda para el sondeo | Superada |  |  | 42
U8 | PUSH | Todo perdido, con rescate | 2026-11-01 | Evento con rescate | Se descartan todos los PUSH_EVENT | PRO-5 | El evento se entrega por la via del sondeo | Superada |  |  | 42
U9 | PUSH | Rescate con otra carga ya encolada | 2026-11-01 | Carga A pendiente; evento B con rescate | Se descartan todos los PUSH_EVENT | PRO-5 | No se pierde ninguno de los dos datos | Fallida |  | entregas de la carga: observado 0, esperado 1 | 42
A1 | SEGURIDAD | Repetir un PUSH capturado | 2026-11-01 | Evento ya entregado; atacante con la trama | Reinyeccion | PRO-8 | Sin doble entrega y con el ACK reenviado | Superada |  |  | 42
A1 | SEGURIDAD | Repetir un PUSH capturado | 2026-11-01 | Evento ya entregado; atacante con la trama | Reinyeccion | PRO-8 | Un evento nuevo posterior se acepta | Superada |  |  | 42
A2 | SEGURIDAD | Alterar la carga o la cabecera | 2026-11-01 | Dos nodos; atacante con una trama legitima | Reinyeccion con un byte alterado | PRO-8 | Las dos tramas se rechazan por el MIC, sin efecto alguno | Superada |  |  | 42
A2 | SEGURIDAD | Alterar la carga o la cabecera | 2026-11-01 | Dos nodos; atacante con una trama legitima | Reinyeccion con un byte alterado | PRO-8 | La sesion sigue intacta | Superada |  |  | 42
A3 | SEGURIDAD | Devolver al nodo su propio ACK | 2026-11-01 | Evento perdido cuya secuencia coincide con la de un ACK capturado del nodo | Reinyeccion del ACK | PRO-8 | El nodo no da por entregado un evento que el gateway no recibio | Superada |  |  | 42
A4 | SEGURIDAD | Agotar el contador en una sesion | 2026-11-01 | Un nodo asociado, airtime fijo de 1 ms | 65 536 eventos en una sesion | PRO-8 | No se reutiliza el flujo de cifrado dentro de una sesion | Fallida | A4: el contador da la vuelta sin renovar la clave | numeros de secuencia repetidos en la sesion: observado 1, esperado 0 | el mismo texto no debe cifrarse igual dos veces | 42
A4 | SEGURIDAD | Agotar el contador en una sesion | 2026-11-01 | Un nodo asociado, airtime fijo de 1 ms | 65 536 eventos en una sesion | PRO-8 | Una orden capturada no se ejecuta otra vez tras media escala del contador | Fallida | A4: sin renovar la clave, la proteccion dura media escala del contador | ejecuciones de la captura: observado 1, esperado 0 | 42
A5 | SEGURIDAD | Tramas truncadas, longitudes extremas y tipos desconocidos | 2026-11-01 | Un nodo asociado; atacante con una trama legitima | Reinyeccion de tramas malformadas | PRO-8 | Todas se descartan como malformadas, sin caida ni respuesta | Superada |  |  | 42
A5 | SEGURIDAD | Tramas truncadas, longitudes extremas y tipos desconocidos | 2026-11-01 | Un nodo asociado; atacante con una trama legitima | Reinyeccion de tramas malformadas | PRO-8 | El estado no cambia | Superada |  |  | 42
S1 | SILENCIO | El gateway deja de emitir | 2026-11-01 | Silencio de 5 s y sin sondeo | Ninguno | PRO-9 | El nodo repite el JOIN sin reiniciarse | Superada |  |  | 42
S2 | SILENCIO | Funcionamiento normal prolongado | 2026-11-01 | Silencio de 8 s; sondeo cada 2 s | Ninguno | PRO-9 | Ninguna reasociacion falsa | Superada |  |  | 42
S4 | SILENCIO | Reinicio del gateway con tres nodos | 2026-11-01 | Tres nodos, dos con direccion dinamica; silencio de 8 s; sondeo cada 2 s | Reinicio del gateway | PRO-9 | Los tres se reasocian | Superada |  |  | 42
S4 | SILENCIO | Reinicio del gateway con tres nodos | 2026-11-01 | Tres nodos, dos con direccion dinamica; silencio de 8 s; sondeo cada 2 s | Reinicio del gateway | PRO-9 | Cada uno recupera su direccion | Superada |  |  | 42
SIM1 | SIMULADOR | Determinismo | 2026-11-01 | Escenario de 4 nodos con 20 % de perdida | Ninguno | RNF-5 | La misma semilla reproduce exactamente la misma traza | Superada |  |  | 42
SIM1 | SIMULADOR | Determinismo | 2026-11-01 | Escenario de 4 nodos con 20 % de perdida | Ninguno | RNF-5 | Otra semilla produce otra traza | Superada |  |  | 42
SIM2 | SIMULADOR | Aislamiento entre mundos | 2026-11-01 | Un mundo previo con actividad | Ninguno | RNF-5 | Un mundo nuevo no hereda reloj, traza ni sesiones del anterior | Superada |  |  | 42
SIM3 | SIMULADOR | Un estimulo que no ocurre da No concluyente | 2026-11-01 | Un nodo asociado | Regla sobre el 9.o ACK, que nunca aparece | RNF-5 | Aunque se cumplan las aserciones, la propiedad no se da por superada | Superada |  |  | 42
SIM4 | SIMULADOR | Acciones de inyeccion de fallos | 2026-11-01 | Un nodo asociado que emite un evento | Una regla distinta en cada sub-caso | RNF-5 | DROP: la trama elegida no llega y el nodo la repite | Superada |  |  | 42
SIM4 | SIMULADOR | Acciones de inyeccion de fallos | 2026-11-01 | Un nodo asociado que emite un evento | Una regla distinta en cada sub-caso | RNF-5 | DELAY: la trama llega con el retraso pedido | Superada |  |  | 42
SIM4 | SIMULADOR | Acciones de inyeccion de fallos | 2026-11-01 | Un nodo asociado que emite un evento | Una regla distinta en cada sub-caso | RNF-5 | DUPLICATE: el receptor recibe dos copias de una sola emision | Superada |  |  | 42
SIM4 | SIMULADOR | Acciones de inyeccion de fallos | 2026-11-01 | Un nodo asociado que emite un evento | Una regla distinta en cada sub-caso | RNF-5 | CORRUPT: la trama alterada se traza como descartada por MIC | Superada |  |  | 42
SIM4 | SIMULADOR | Acciones de inyeccion de fallos | 2026-11-01 | Un nodo asociado que emite un evento | Una regla distinta en cada sub-caso | RNF-5 | REORDER: la primera trama se entrega despues de la segunda | Superada |  |  | 42
SIM5 | SIMULADOR | Modelo de canal | 2026-11-01 | Canal declarado en spec/modelo_canal.md | Ninguno | RNF-5 | El airtime coincide con el calculo a mano: 11 B en SF7/125 kHz son 41,2 ms | Superada |  |  | 42
SIM5 | SIMULADOR | Modelo de canal | 2026-11-01 | Canal declarado en spec/modelo_canal.md | Ninguno | RNF-5 | Sin ventana ciega, dos nodos simultaneos no colisionan; con ella, si | Superada |  |  | 42
SIM5 | SIMULADOR | Modelo de canal | 2026-11-01 | Canal declarado en spec/modelo_canal.md | Ninguno | RNF-5 | Una trama que el enlace va a perder sigue ocupando el canal | Superada |  |  | 42
SIM5 | SIMULADOR | Modelo de canal | 2026-11-01 | Canal declarado en spec/modelo_canal.md | Ninguno | RNF-5 | La perdida es por enlace: solo afecta al receptor indicado | Superada |  |  | 42
SIM5 | SIMULADOR | Modelo de canal | 2026-11-01 | Canal declarado en spec/modelo_canal.md | Ninguno | RNF-5 | Un emisor ajeno destruye una trama solapada y queda trazado | Superada |  |  | 42
T-PER | TIME_SYNC | Difusion periodica | 2026-11-01 | TIME_SYNC cada 1 s; nodo sin JOIN automatico | Ninguno | PRO-7 | Se emite sola, con el periodo configurado | Superada |  |  | 42
T1 | TIME_SYNC | Llega un TIME_SYNC | 2026-11-01 | Un nodo asociado | TIME_SYNC con 1000 s | PRO-7 | El desfase del nodo pasa a ser la hora del gateway menos su reloj | Superada |  |  | 42
T2 | TIME_SYNC | Solo llegan TIME_SYNC | 2026-11-01 | Silencio de 10 s; TIME_SYNC cada 2 s; sin sondeo | Ninguno | PRO-7 | El nodo recibe los TIME_SYNC | Superada |  |  | 42
T2 | TIME_SYNC | Solo llegan TIME_SYNC | 2026-11-01 | Silencio de 10 s; TIME_SYNC cada 2 s; sin sondeo | Ninguno | PRO-9 | Los TIME_SYNC no cuentan como senal de vida: se detecta el silencio | Superada |  |  | 42
