javicone/LoRaLAN_TFG/LORALAN_LIB/sim_LoRaLAN/results/perf/summary.csv

backlog_end | blind | cad_busy | collided_ack | collided_poll | collided_push | collided_response | confirmed | confirmed_ic_hi | confirmed_ic_lo | confirmed_pct | delayed | delivered | delivered_ic_hi | delivered_ic_lo | delivered_not_confirmed | delivered_pct | duplicates | duty_gateway_pct | duty_gateway_pct_ic | duty_gateway_pct_n | duty_worst_node_pct | duty_worst_node_pct_ic | duty_worst_node_pct_n | exp | false_confirmed | false_inactive | join_all_ms | join_all_ms_ic | join_all_ms_n | join_fail | join_requests | lat_max | lat_max_ic | lat_max_n | lat_p50 | lat_p50_ic | lat_p50_n | lat_p95 | lat_p95_ic | lat_p95_n | lat_p99 | lat_p99_ic | lat_p99_n | loss | max_seeds | node_hours | nodes | offered | poll | polls | rate | replicas | responses | tx_delivered | tx_push | tx_total
 |  |  |  |  |  |  |  |  |  |  |  | 6000 | 100.0 | 99.936 |  | 100.0 |  |  |  |  |  |  |  | VAL |  |  |  |  |  | 0 |  |  |  |  |  |  |  |  |  |  |  |  |  | 0 |  |  |  | 6000 |  |  |  | 30 |  | 6000 |  | 6000
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
