javicone/LoRaLAN_TFG/LORALAN_LIB/sim_LoRaLAN/results/trazas/A2.csv

mundo | t_ms | evento | disp | tipo | seq | flags | long | motivo | valor | detalle
0 | 1000 | CAD_FREE | 1 |  | 0 | 0 | 0 |  | 0
0 | 1000 | TX | 1 | JOIN_REQUEST | 0 | 1 | 19 |  | 0
0 | 1052 | TX | 0 | JOIN_ACCEPT | 0 | 1 | 21 |  | 0
0 | 1052 | APP_NODE_JOINED | 0 |  | 0 | 0 | 0 |  | 32
0 | 1052 | RX_OK | 0 | JOIN_REQUEST | 0 | 1 | 19 |  | 0
0 | 1052 | RX_OK | 2 | JOIN_REQUEST | 0 | 1 | 19 |  | 0
0 | 1052 | STATE | 0 |  | 0 | 0 | 0 |  | 1 | nodos_activos
0 | 1109 | APP_JOIN_ACCEPTED | 1 | JOIN_ACCEPT | 0 | 0 | 0 |  | 0
0 | 1109 | TX | 1 | ACK | 0 | 0 | 11 |  | 0
0 | 1109 | RX_OK | 1 | JOIN_ACCEPT | 0 | 1 | 21 |  | 0
0 | 1109 | RX_DROP | 2 | JOIN_ACCEPT | 0 | 1 | 21 | REJECTED_BY_ROLE | 0
0 | 1109 | STATE | 1 |  | 0 | 0 | 0 |  | 1 | asociado
0 | 1137 | CAD_BUSY | 2 |  | 0 | 0 | 0 |  | 0
0 | 1151 | RX_OK | 0 | ACK | 0 | 0 | 11 |  | 0
0 | 1151 | RX_DROP | 2 | ACK | 0 | 0 | 11 | NOT_ADDRESSED | 0
0 | 2363 | CAD_FREE | 2 |  | 0 | 0 | 0 |  | 0
0 | 2363 | TX | 2 | JOIN_REQUEST | 1 | 1 | 19 |  | 0
0 | 2415 | TX | 0 | JOIN_ACCEPT | 1 | 1 | 21 |  | 0
0 | 2415 | APP_NODE_JOINED | 0 |  | 0 | 0 | 0 |  | 33
0 | 2415 | RX_OK | 0 | JOIN_REQUEST | 1 | 1 | 19 |  | 0
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
