javicone/LoRaLAN_TFG/LORALAN_LIB/sim_LoRaLAN/results/trazas/A3.csv

mundo | t_ms | evento | disp | tipo | seq | flags | long | motivo | valor | detalle
0 | 1000 | CAD_FREE | 1 |  | 0 | 0 | 0 |  | 0
0 | 1000 | TX | 1 | JOIN_REQUEST | 0 | 1 | 19 |  | 0
0 | 1052 | TX | 0 | JOIN_ACCEPT | 0 | 1 | 21 |  | 0
0 | 1052 | APP_NODE_JOINED | 0 |  | 0 | 0 | 0 |  | 32
0 | 1052 | RX_OK | 0 | JOIN_REQUEST | 0 | 1 | 19 |  | 0
0 | 1052 | STATE | 0 |  | 0 | 0 | 0 |  | 1 | nodos_activos
0 | 1109 | APP_JOIN_ACCEPTED | 1 | JOIN_ACCEPT | 0 | 0 | 0 |  | 0
0 | 1109 | TX | 1 | ACK | 0 | 0 | 11 |  | 0
0 | 1109 | RX_OK | 1 | JOIN_ACCEPT | 0 | 1 | 21 |  | 0
0 | 1109 | STATE | 1 |  | 0 | 0 | 0 |  | 1 | asociado
0 | 1151 | RX_OK | 0 | ACK | 0 | 0 | 11 |  | 0
0 | 1152 | TX | 0 | CMD | 1 | 1 | 17 |  | 0
0 | 1204 | APP_CMD | 1 | CMD | 1 | 0 | 6 |  | 0
0 | 1204 | TX | 1 | ACK | 1 | 0 | 11 |  | 0
0 | 1204 | RX_OK | 1 | CMD | 1 | 1 | 17 |  | 0
0 | 1246 | RX_OK | 0 | ACK | 1 | 0 | 11 |  | 0
0 | 1652 | CAD_FREE | 1 |  | 0 | 0 | 0 |  | 0
0 | 1652 | TX | 1 | PUSH_EVENT | 1 | 1 | 17 |  | 0
0 | 1652 | FAULT | 1 | PUSH_EVENT | 1 | 0 | 0 |  | 0 | DROP
0 | 1802 | TX | 99 | ACK | 1 | 0 | 11 |  | 0
0 | 1844 | RX_OK | 0 | ACK | 1 | 0 | 11 |  | 0
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
