javicone/LoRaLAN_TFG/LORALAN_LIB/sim_LoRaLAN/results/perf/figuras/exp1.png

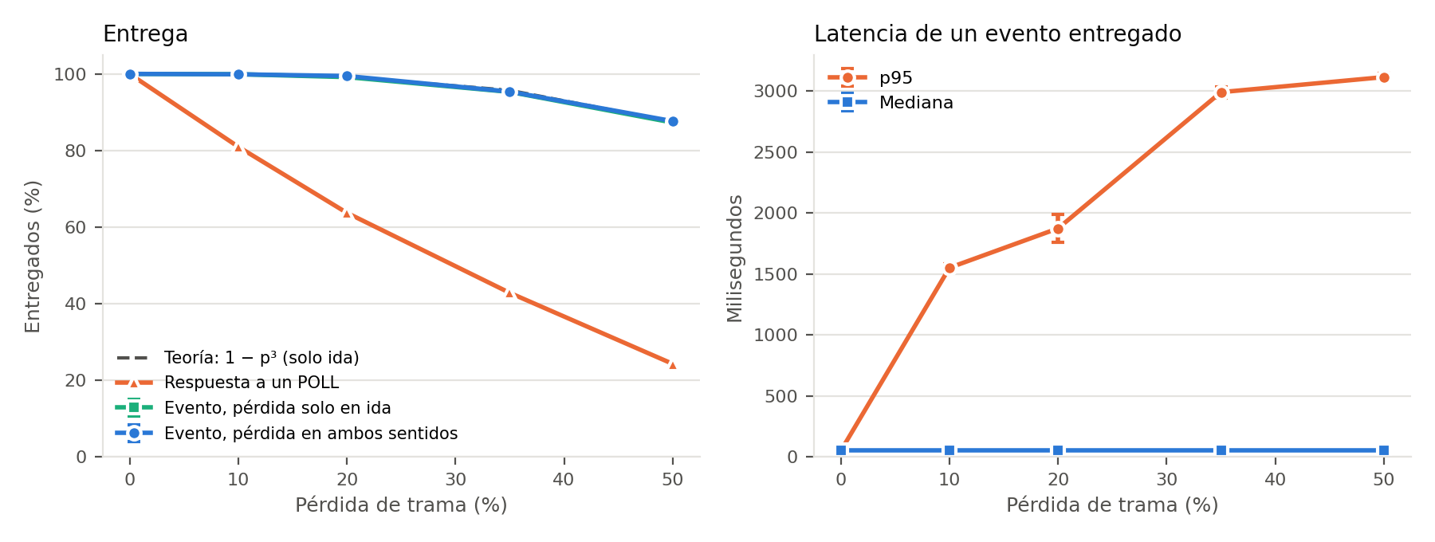
LORALAN_LIB/sim_LoRaLAN/results/perf/figuras/exp1.png
