javicone/LoRaLAN_TFG/LORALAN_LIB/sim_LoRaLAN/results/perf/figuras/exp4_exp5.png

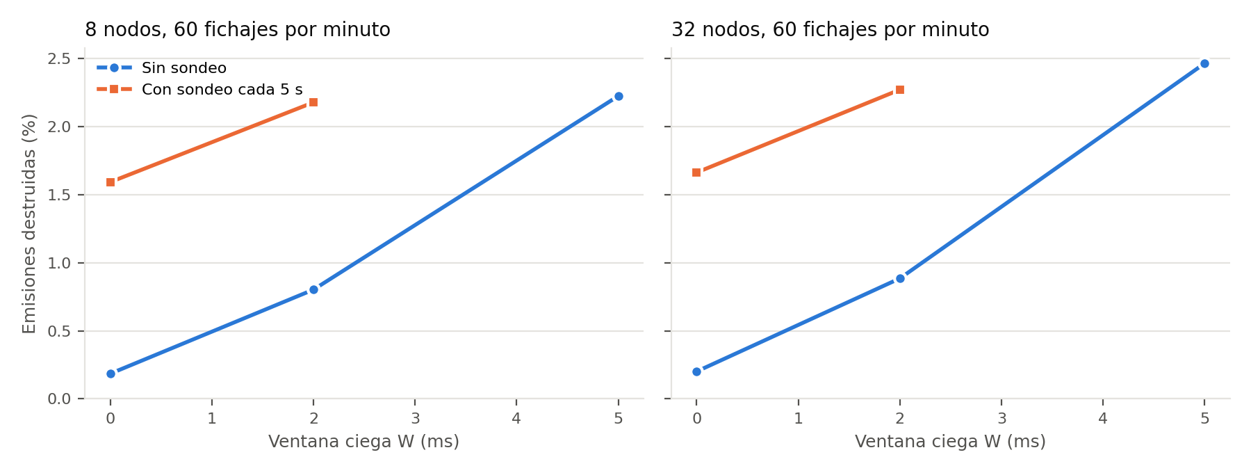
LORALAN_LIB/sim_LoRaLAN/results/perf/figuras/exp4_exp5.png
