javicone/LoRaLAN_TFG/Device_ESP32_LoRaLAN/setupSensores.ino

void initSensores() {
  Serial.println("\n╔════════════════════════════════╗");
  Serial.println("║  INICIALIZACIÓN DE SENSORES    ║");
  Serial.println("╚════════════════════════════════╝\n");

  setupIndicators();  //Inicializamos los indicadores (LEDs y buzzer)
  Serial.println("🔧 Inicializando sensores...");
  
  // Configurar pines de reles
  // Los reles son activos en LOW: LOW=ON, HIGH=OFF
  pinMode(relayPin1, OUTPUT);
  digitalWrite(relayPin1, HIGH); // Relé 1 APAGADO (HIGH = OFF para relés activos en LOW)
  relay1Estado = false;          // Sincronizar estado: false = APAGADO
  
  pinMode(relayPin2, OUTPUT);
  digitalWrite(relayPin2, HIGH); // Relé 2 APAGADO (HIGH = OFF para relés activos en LOW)
  relay2Estado = false;          // Sincronizar estado: false = APAGADO
  
  Serial.println("✅ Relés inicializados (ambos APAGADOS)");
  
  setupNFC();
  delay(200);  //Inicializamos el lector NFC
  setupRadar();  //Inicializamos el radar de presencia
  setupBME();  //Inicializamos el sensor de temperatura, humedad y presión
  setupLightMeter();  //Inicializamos el sensor de luz
  setupDisplay();  // ⬅️ NUEVO
  Serial.setDebugOutput(false); // Desactivar salida de depuración para evitar interferencias I2C

    // Mostrar resumen
  Serial.println("\n=== RESUMEN INICIALIZACIÓN ===");
  Serial.printf("BME280: %s\n", sensores.bme280_ok ? "✅" : "❌");
  Serial.printf("BH1750: %s\n", sensores.bh1750_ok ? "✅" : "❌");
  Serial.printf("LD2410: %s\n", sensores.ld2410_ok ? "✅" : "❌");
  Serial.printf("PN532:  %s\n", sensores.pn532_ok ? "✅" : "❌");
  Serial.printf("OLED:   %s\n", sensores.display_ok ? "✅" : "❌");  // ⬅️ NUEVO
  Serial.println("==============================\n");
  // El LED de reposo lo fija actualizarLedReposo() al final de setup() y en loop().
}
