javicone/LoRaLAN_TFG/(commit log)

2026-09-29 limpieza de archivos sin uso
2026-10-21 cambios menores en el protocolo acorde a la memoria
2026-11-10 README: descripción del proyecto, contenido de cada carpeta y arranque
2026-11-10 Documentación revisada para la lectura del TFG: README de la biblioteca según el código, rutas dentro del repo y limpieza de ficheros sobrantes
2026-11-10 Añade el simulador sim_LoRaLAN (solo las pruebas del capítulo 6), la skill de LoRaLAN y la memoria en LaTeX; documentación actualizada
    [A1.csv, A2.csv, A3.csv, A4.csv, A5.csv, C1.csv, C2.csv, C3.csv]
2026-11-10 Base de datos en la Raspberry Pi (MariaDB): guía de instalación y create_user.py con argumentos y roles válidos
2026-11-12 Servidor: clase automática al primer fichaje sin clase programada, webservice con timeout de 0,5 s y «clase en curso» en el panel desde la BD
    - asistencia_service: si no hay clase en la BD ni en el webservice, el primer
    profesor que ficha abre una «Clase sin programar» suya hasta la siguiente
    hora en punto; otro profesor en esa hora recibe DENEGADO (403).
    - claseRepository: timeout del webservice de horarios de 10 s a 0,5 s, para
    responder dentro del plazo del gateway (800 ms).
    - /panel/estado: clase_en_curso se calcula desde la tabla clases
    (nodos_con_clase_en_curso en repositories/nodos.py).
    - Pruebas nuevas en scripts/test_gateway_panel.py (20/20) y README actualizado.
2026-11-12 Firmware: OLED del nodo girada 180º y correcciones del monitor Cardputer
    - Device_ESP32_LoRaLAN: setRotation(2) porque la OLED va montada del revés.
    - MonitorCardputer: el contador de tramas por minuto se cierra aunque no
    lleguen tramas (un minuto vacío cuenta 0); un JOIN_REQUEST con origen 0 ya
    no se apunta al gateway; la barra y la cabecera del ciclo de trabajo usan
    DUTY_LIMITE_PCT (10 %, sub-banda de 869,525 MHz) en lugar del 1 % fijo.
    - README del monitor: aviso de ciclo de trabajo por encima del 10 %.
2026-11-12 Plan pendiente (sin implementar): ligar el aula a la MAC del nodo en lugar de a su dirección LoRaLAN
2026-11-12 Nodo: LED de reposo fijo (verde/amarillo) y pitidos solo en el fichaje
    - LED de reposo fijo: verde si los cuatro sensores y el enlace LoRa van bien,
    amarillo si falla alguno o el nodo no esta asociado; vuelve solo a su color
    tras cada fichaje (actualizarLedReposo en setup y loop).
    - Sin pitidos ni parpadeos por fallos de sensor, LoRa o radio (fuera ERROR y
    CRITICO). Se conserva la secuencia de arranque para comprobar la placa.
    - El parpadeo queda para el resultado del fichaje; secuenciaError solo en rojo.
    Escrito sin compilar ni probar en placa.
    [BME_module.ino, Device_ESP32_LoRaLAN.ino, LightMeter_module.ino, globals.h, indicators.ino, radar_module.ino, setupSensores.ino]
